AllanGallop/mini-web-radio-5ghz-backpack/hardware/v1.brd

## EAGLE design hardware/v1.brd (2026-01-20)

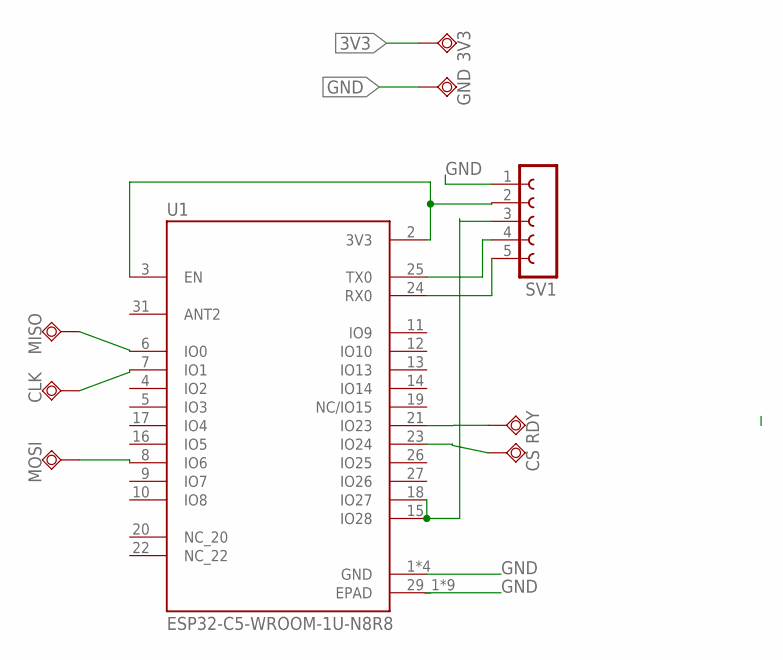
[picture p7: schematic v1.sch]

Parts:
3V3: TPSQTP09SQ; TP09SQ
CLK: TPSQTP09SQ; TP09SQ
CS: TPSQTP09SQ; TP09SQ
GND: TPSQTP09SQ; TP09SQ
MISO: TPSQTP09SQ; TP09SQ
MOSI: TPSQTP09SQ; TP09SQ
RDY: TPSQTP09SQ; TP09SQ
SV1: FE05-1
U1: ESP32-C5-WROOM-1U-N8R8; XCVR_ESP32-C5-WROOM-1U-N8R8

Connections:
3V3: 3V3.TP, SV1.2, U1.2 (3V3), U1.3 (EN)
GND: GND.TP, SV1.1, U1.1 (GND), U1.28 (GND), U1.29_1 (EPAD), U1.29_2 (EPAD), U1.29_3 (EPAD), U1.29_4 (EPAD), U1.29_5 (EPAD), U1.29_6 (EPAD), U1.29_7 (EPAD), U1.29_8 (EPAD), U1.29_9 (EPAD), U1.30 (GND), U1.32 (GND)
unnamed: RDY.TP, U1.21 (IO23)
unnamed: CS.TP, U1.23 (IO24)
unnamed: MISO.TP, U1.6 (IO0)
unnamed: CLK.TP, U1.7 (IO1)
unnamed: SV1.3, U1.15 (IO28), U1.18 (IO27)
unnamed: MOSI.TP, U1.8 (IO6)
unnamed: SV1.5, U1.24 (RX0)
unnamed: SV1.4, U1.25 (TX0)

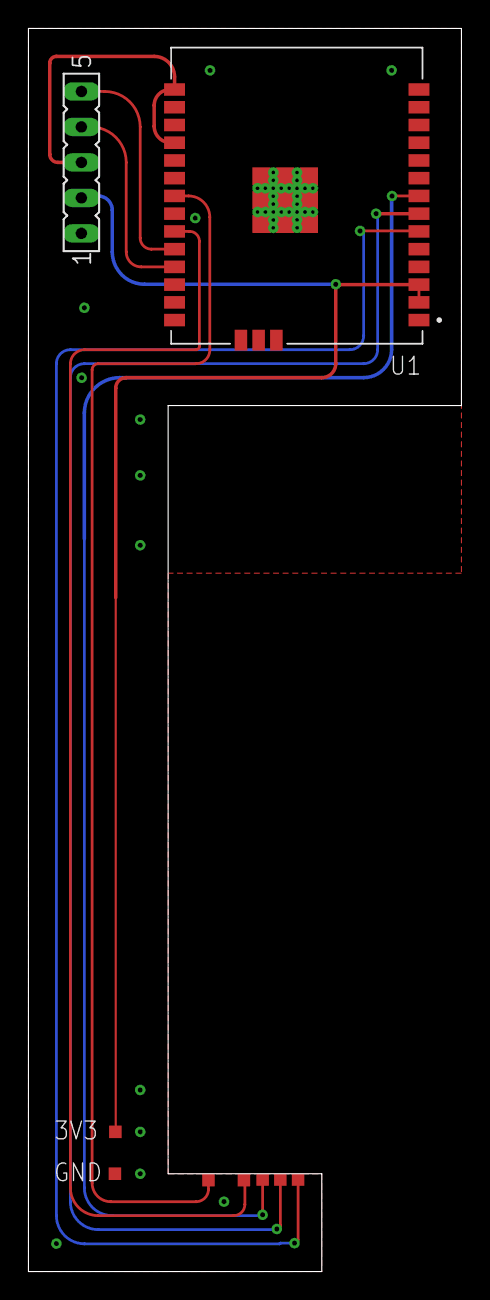
[picture p8: board v1.brd from above]

Board: 2 copper layers, 31.0 x 89.0 mm, 9 parts (0 on the bottom side), 10 nets.
